OmarSaadany/Weather-Station/DOCs/Weather Station Proposal.docx

Item | | Price | link
2 | Solar Panel | 400 | https://ampere-electronics.com/product/solar-panel-10w-18v-238x360mm/
3 | Charge Controller | 450 | https://ram-e-shop.com/product/pwm-solar-charge-controller-12v-24v-auto-30a-ft-d1230/
4 | Battery 12 v | 450 | https://makerselectronics.com/product/acid-battery-12v-2ah
5 | GSM | 2x220 | https://store.fut-electronics.com/products/sim800l-gprs-gsm-module?_pos=9&_sid=cd140909e&_ss=r
6 | Blue Pill | 2x180 | https://store.fut-electronics.com/products/copy-of-stm32f103c8t6-stm32-development-board-original-ic-the-blue-pill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
7 | Limit Switch | 10x2 | https://ram-e-shop.com/product/ms-3/
8 | 5X Regulator | 5x5=25 | https://ram-e-shop.com/product/lm317t/
| Flow sensor | 375 | https://ram-e-shop.com/product/sen-fs300a-water-flow/
| Female Pin Headers | 5x3 | https://store.fut-electronics.com/products/female-pin-headers-standard-2-54-mm-40-pin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
| male-male-jumper | 1.5 | https://store.fut-electronics.com/products/male-male-jumper-wire-400-mm?_pos=3&_sid=816fa6d71&_ss=r
| Male female | 1.5 | https://store.fut-electronics.com/products/male-female-jumper-wire-400-mm?_pos=7&_sid=816fa6d71&_ss=r
| Female female | 1.5 | https://store.fut-electronics.com/products/female-female-jumper-wire-400-mm?_pos=12&_sid=816fa6d71&_ss=r
| T block 4pins | 5*5 | https://store.fut-electronics.com/products/pcb-terminal-block-5mm-pitch-4pin?_pos=11&_sid=86df6474a&_ss=r
| 3 pins | 4 | https://store.fut-electronics.com/products/pcb-terminal-block-5mm-pitch-3pin?_pos=12&_sid=86df6474a&_ss=r
| Heat sink | 4.5 LE*6 | https://store.fut-electronics.com/products/heatsink-1?_pos=1&_sid=44304f6ac&_ss=r
| 7805 | 5LE*3 | https://store.fut-electronics.com/products/l7805cv-positive-voltage-regulator-5v-1a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
| Rotary encoder | 55 | https://ram-e-shop.com/product/kit-ky040-rotary-encoder/
| Magnetic encoder | 160 | https://store.fut-electronics.com/products/magnetic-encoder-rotary-position-sensor-as5600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
| IR Encoder | 180 | https://ram-e-shop.com/product/speed-measuring-module-encoder-disk-set-for-smart-car-chassis/
