OmarSaadany/Weather-Station/PCB Design/V2/GSM.DXF

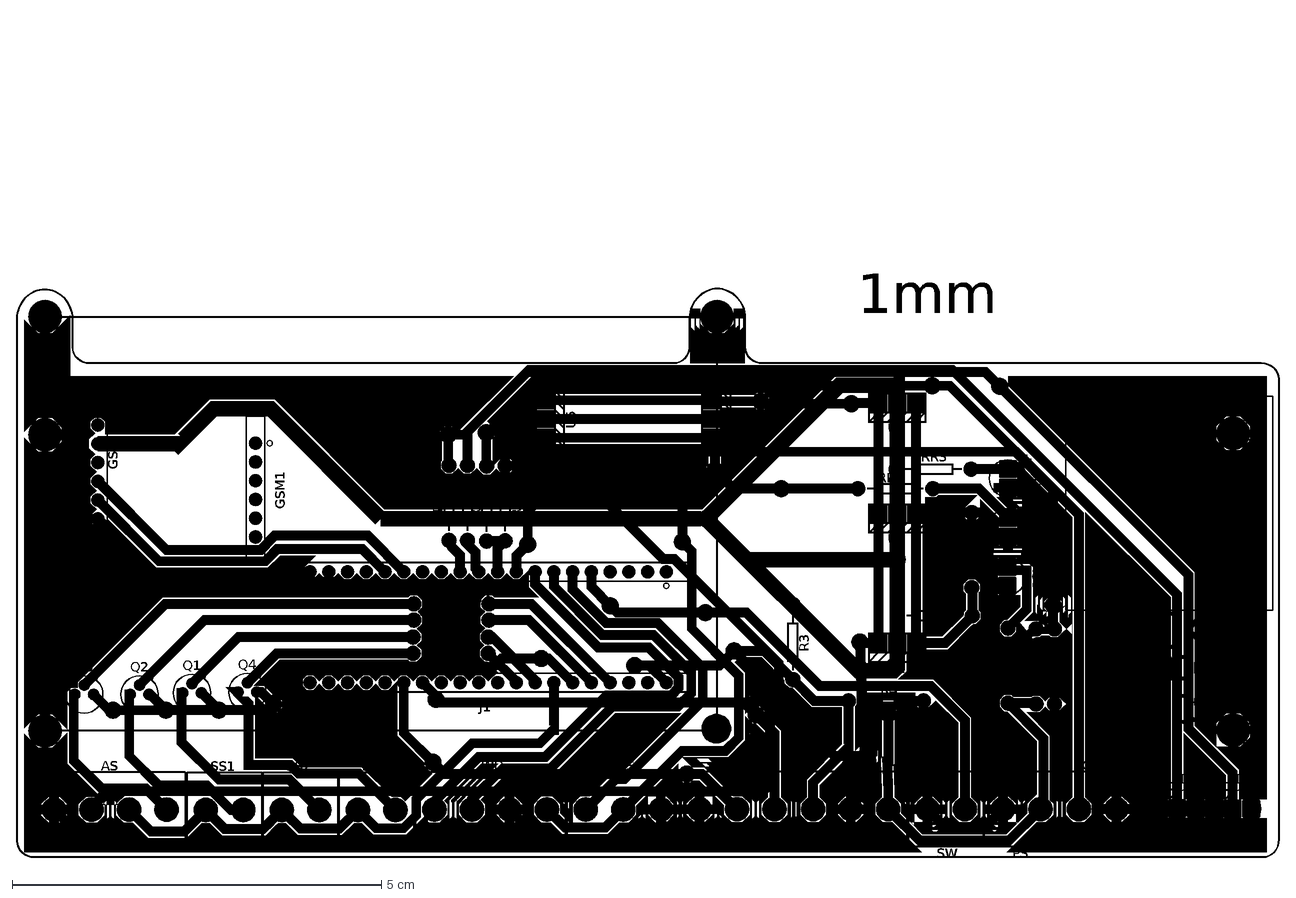
[picture p35: CAD file, 2024-02-18]
PCB Design/V2/GSM.DXF
GSM
J1
J2
GSM1
AS
Q4
R8
R5
Q1
PS
U1
U2
U3
U4
U5
12V
5V
RR1
RR2
Q2
R6
Q3
R7
R1
R2
R3
R4
SW
WD
WS
4V
RR3
S1
S2
SS1
SS2
SS3
R11
R12
R9
R10
R
RR
SOLAR
LED1
LED2
1mm
DK
Innovation
Labs
40mm
