OmarSaadany/Weather-Station/PCB Design/V2/GSM.PDF

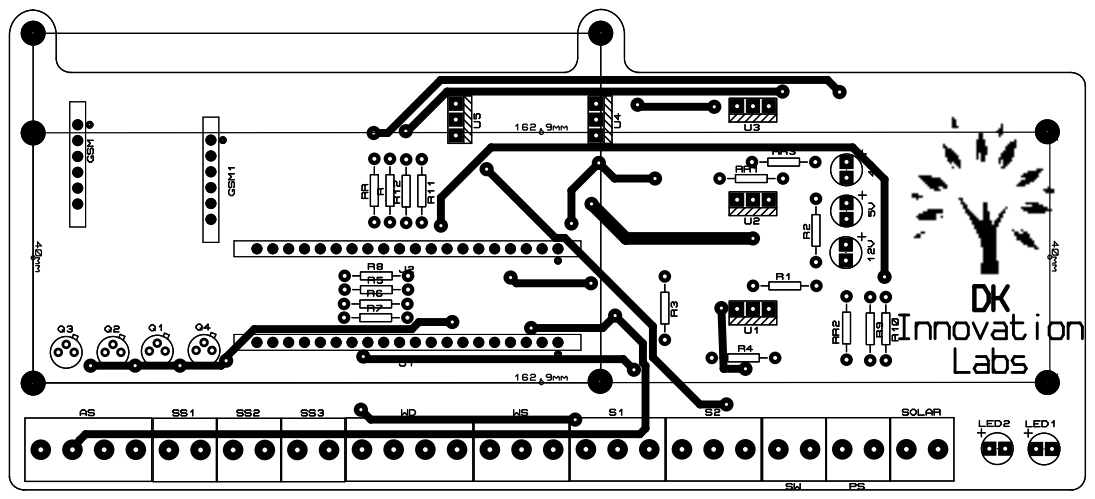
[picture p36: page 1]
