OmarSaadany/Weather-Station/PCB Design/Manufacturing Files/GSM_Mirror.PDF

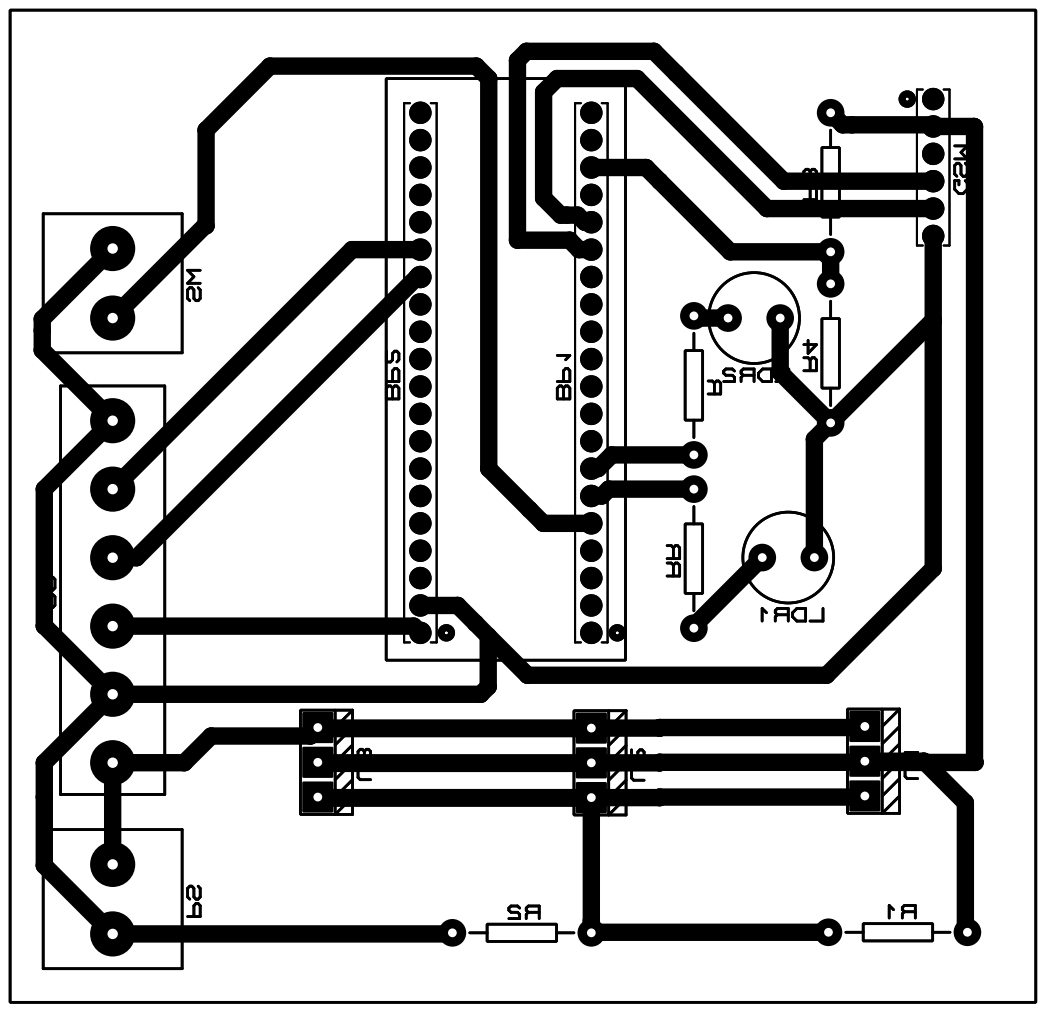
[picture p37: page 1]
