OmarSaadany/Weather-Station/(list of files, drawings)

Other design files:
PCB Design/Proteus Design/GSM.pdsprj
PCB Design/V2/GSM.pdsprj
PCB Design/V2/Project Backups/GSM [20231207, 17-36-30].pdsprj
PCB Design/V2/Project Backups/GSM [20231207, 17-36-31].pdsprj
PCB Design/V2/Project Backups/GSM [20231207, 17-36-32].pdsprj
PCB Design/V2/Project Backups/GSM [20240116, 13-15-07].pdsprj
PCB Design/V2/Project Backups/GSM [20240116, 13-17-36].pdsprj
PCB Design/V2/Project Backups/GSM [20240118, 11-22-48].pdsprj
PCB Design/V2/Project Backups/GSM [20240118, 11-44-44].pdsprj
PCB Design/V2/Project Backups/GSM [20240118, 12-48-58].pdsprj
PCB Design/V2/Project Backups/GSM [20240118, 12-49-00].pdsprj
PCB Design/V2/Project Backups/GSM [20240118, 12-51-57].pdsprj
