OmarSaadany/Weather-Station/Wind sensors/Inc/SoilSensor.h

/*
 * SoilSensor.h
 *
 *  Created on: Nov 8, 2023
 *      Author: SaadanyOmar
 */

#ifndef SOILSENSOR_H_
#define SOILSENSOR_H_
#include "STD_TYPES.h"
#include "BIT_MATH.h"
#include "USART_interface.h"

void SOIL_voidSensorReadData(void);


#endif /* SOILSENSOR_H_ */
