OmarSaadany/Weather-Station/Wind sensors/Src/GSM_program.c

/*
 * GSM_program.c
 *
 *  Created on: Nov 8, 2023
 *      Author: SaadanyOmar
 */

#include "STD_TYPES.h"
#include "BIT_MATH.h"
#include "GSM_interface.h"
#include "USART3_interface.h"


// this string used with GSM_voidSendData function to convert float numbers into array by using ftoa function
u8 ftoa_Result[20];


// these data are global in SOILSENSOR files and updated before calling GSM_voidSendData
extern f32 soilHumidity	 	    ;
extern f32 soilTemperature  	;
extern u16 soilConductivity 	;
extern f32 soilPH 				;
extern u16 soilnitrogen 		;
extern u16 soilphosphorus 		;
extern u16 soilpotassium 		;
extern f32 SensorTempRead       ;
extern f32 SensorHumdRead       ;
extern u8  DoorStatus			;
extern f32 volt					;


extern u8 GSMSTATUS[25]			; 	// used to receive GSM respond after uploading data to reconnect to the network if the upload failed
u8 GSMTimeOut=0			;	// time out used to detect if the GSM did not respond to prevent the CPU to stuck in Receiving function



// simple busy wait function
void	_delay_ms(u32 ticks)
{
	u32 i;
	for( i = 0; i < (ticks * 500) ; i++)
	{
		asm("NOP");
	}
}



/* Function:-			void GSM_voidConnectToNetwork(void);
 * I/O Parameters:-		void
 * Returns:- 			Void
 * Description:-
 * 		connect GSM to network and initialize HTTP mode
 */
void GSM_voidConnectToNetwork (void)
{
	// send AT to make GSM ready to start and sync with boud rate
	USART3_voidSendString("AT");
	USART3_voidSendString("\r\n");
	_delay_ms(100);
	USART3_voidSendString("AT");
	USART3_voidSendString("\r\n");
	_delay_ms(1000);
	USART3_voidSendString("AT+CPIN?");
	USART3_voidSendString("\r\n");
	_delay_ms(1000);
	USART3_voidSendString("AT+CFUN=1");
	USART3_voidSendString("\r\n");
	_delay_ms(1000);
	USART3_voidSendString("AT+CREG?");
	USART3_voidSendString("\r\n");
	_delay_ms(1000);
	USART3_voidSendString("AT+CGATT?");
	USART3_voidSendString("\r\n");
	_delay_ms(1000);
	USART3_voidSendString("AT+SAPBR=3,1,\"CONTYPE\",\"GPRS\"");
	USART3_voidSendString("\r\n");
	_delay_ms(1000);
	USART3_voidSendString("AT+SAPBR=3,1,\"APN\",\"internet.vodafone.net\"");
	USART3_voidSendString("\r\n");
	_delay_ms(1000);
	USART3_voidSendString("AT+SAPBR=3,1,\"USER\",\"internet\"");
	USART3_voidSendString("\r\n");
	_delay_ms(1500);
	USART3_voidSendString("AT+SAPBR=1,1");
	USART3_voidSendString("\r\n");
	_delay_ms(1000);
	USART3_voidSendString("AT+SAPBR=2,1");
	USART3_voidSendString("\r\n");
	_delay_ms(1500);
	USART3_voidSendString("AT+HTTPINIT");
	USART3_voidSendString("\r\n");

}




/* Function:-			void GSM_voidSendData(void);
 * I/O Parameters:-		void
 * Returns:- 			Void
 * Description:-
 * 		update data to google sheet
 */
void GSM_voidSendData(void)
{
	USART3_voidSendString("AT");
	USART3_voidSendString("\r\n");
	_delay_ms(50);
	USART3_voidSendString("AT");
	USART3_voidSendString("\r\n");
	_delay_ms(50);
	// enable HTTPSSL
	USART3_voidSendString("AT+HTTPSSL=1");
	USART3_voidSendString("\r\n");
	_delay_ms(500);

	// Send google sheet script link
	USART3_voidSendString("AT+HTTPPARA=\"URL\",\"https://script.google.com/macros/s/AKfycbykF8SKIREqFvZkoBSAbIT5z8wO0gK62gn2uFlCY_dtvy8bBGt6Wy3nKZo4f5hE1kPP/exec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");

	// scaleID= is the first macro then send its value as string
	USART3_voidSendString("soilHumidity=");
	ftoa(soilHumidity, ftoa_Result, 2);
	USART3_voidSendString(ftoa_Result);

	USART3_voidSendString("&soilTemperature=");
	ftoa(soilTemperature, ftoa_Result, 2);
	USART3_voidSendString(ftoa_Result);

	USART3_voidSendString("&soilConductivity=");
	intToStr(soilConductivity, ftoa_Result, 3) ;
	USART3_voidSendString(ftoa_Result);

	USART3_voidSendString("&soilPH=");
	ftoa(soilPH, ftoa_Result, 2);
	USART3_voidSendString(ftoa_Result);

	USART3_voidSendString("&soilNitrogen=");
	intToStr(soilnitrogen, ftoa_Result, 2) ;
	USART3_voidSendString(ftoa_Result);

	USART3_voidSendString("&soilPhosphorus=");
	intToStr(soilphosphorus, ftoa_Result, 2) ;
	USART3_voidSendString(ftoa_Result);

	USART3_voidSendString("&soilPotassium=");
	intToStr(soilpotassium, ftoa_Result, 2) ;
	USART3_voidSendString(ftoa_Result);

	USART3_voidSendString("&airTemperature=");
	ftoa(SensorTempRead, ftoa_Result, 2);
	USART3_voidSendString(ftoa_Result);

	USART3_voidSendString("&airHumididty=");
	ftoa(SensorHumdRead, ftoa_Result, 2);
	USART3_voidSendString(ftoa_Result);


	if (DoorStatus==0)
	{
		USART3_voidSendString("&doorStatus=Closed");
	}
	else
	{
		USART3_voidSendString("&doorStatus=Opened");
	}

	USART3_voidSendString("&volt=");
	ftoa(volt, ftoa_Result, 2);
	USART3_voidSendString(ftoa_Result);

	USART3_voidSendString("\"\r\n");
	_delay_ms(3000);

	USART3_voidSendString("AT+HTTPACTION=0");
	USART3_voidSendString("\r\n");
	_delay_ms(3000);
}





void GSM_voidReceivedStatus (void)
{
	// receive 23 character as a respond from GSM
	for (u8 i =0 ; i<23; i++)
	{
		if(i == 0) 				// the first char in expected respond array is '+' so we need a special condition for the first element until we receive '+'
		{
			while (GSMSTATUS[0]!='+' && GSMTimeOut<250) // while it did not receive '+' and the time out value is less than 250, stay in the loop
			{
				GSMSTATUS[0]=USART3_u8ReciveData();		// Receive byte and save it in the first element
				GSMTimeOut++;							// increment the timeout value
			}
			GSMTimeOut=0;								// Timeout value = 0 to use it in the next loop

			if (GSMSTATUS[0]!='+' ) // if timeout exceeded the limit and the USART did not receive '+' in the first element
			{
				break;				// break the FOR loop
			}
		}

		else // if i bigger than 0
		{
			GSMSTATUS[i]=USART3_u8ReciveData(); 		//  Receive byte and save it in the (index of i) element
		}
	}

}


/* Function:-			void GSM_voidPhoneCall(u8* PhoneNumSTR);
 * I/O Parameters:-		u8*
 * Returns:- 			Void
 * Description:-
 * 		used to make a phone call
 */
void GSM_voidPhoneCall(u8* PhoneNumSTR){
	// use ATD command to make a phone call
	USART3_voidSendString("ATD");
	USART3_voidSendString(PhoneNumSTR);
	USART3_voidSendString(";\r\n");

}


/* Function:-			void GSM_voidSendSMS (u8* PhoneNumSTR, u8* SMS);
 * I/O Parameters:-		u8*, u8*
 * Returns:- 			Void
 * Description:-
 * 		used to make a phone call
 */
void GSM_voidSendSMS (u8* PhoneNumSTR, u8* SMS)
{
	USART3_voidSendString("AT+CMGF=1");
	USART3_voidSendString("\r\n");
	_delay_ms(100);
	USART3_voidSendString("AT+CMGS=");
	USART3_voidSendByte('"');
	USART3_voidSendString(PhoneNumSTR);
	USART3_voidSendByte('"');
	USART3_voidSendString("\r\n");
	_delay_ms(100);
	USART3_voidSendString(SMS);
	USART3_voidSendString("\r\n");
	USART3_voidSendByte(0x1A);
}






void reverse(u8* str, u16 len)
{
	// this func reverse the string
	int i = 0, j = len - 1, temp;
	while (i < j) {
		temp = str[i];
		str[i] = str[j];
		str[j] = temp;
		i++;
		j--;
	}
}

u16  intToStr(u16 x, u8 str[], u16 d)
{// change int value to string of char
	u16 i = 0;
	while (x) {
		str[i++] = (x % 10) + '0';
		x = x / 10;
	}

	// If number of digits required is more, then
	// add 0s at the beginning
	while (i < d)
		str[i++] = '0';

	reverse(str, i);
	str[i] = '\0';
	return i;
}

// Converts a floating-point/double number to a string.
void ftoa(f32 n, u8* res, u16 afterpoint)
{
	// Extract integer part
	u16 ipart = (u16)n;

	// Extract floating part
	f32 fpart = n - (f32)ipart;

	// convert integer part to string
	u16 i = intToStr(ipart, res, 0);

	// check for display option after point
	if (afterpoint != 0) {
		res[i] = '.'; // add dot

		// Get the value of fraction part upto given no.
		// of points after dot. The third parameter
		// is needed to handle cases like 233.007
		fpart = fpart * pow(10, afterpoint);

		intToStr((u16)fpart, res + i + 1, afterpoint);
	}
}
