OmarSaadany/Weather-Station/Wind sensors/Inc/TIM2_config.h

/*
 * TIM2_config.h
 *
 *  Created on: Jan 9, 2024
 *      Author: SaadanyOmar
 */

#ifndef TIM2_CONFIG_H_
#define TIM2_CONFIG_H_




#define 	TIM2_Mode				TIM2_CounterMode




#define		TIM2_CounterMode 		1


#define 	TIM2_ReloadValue		0xffff


#endif /* TIM2_CONFIG_H_ */
