OmarSaadany/Weather-Station/Wind sensors/Inc/TIM2_interface.h

/*
 * TIM2_interface.h
 *
 *  Created on: Jan 9, 2024
 *      Author: SaadanyOmar
 */

#ifndef TIM2_INTERFACE_H_
#define TIM2_INTERFACE_H_


void TIM2_voidInit (void);

u32  TIM2_u32GetCounterValue (void);


#endif /* TIM2_INTERFACE_H_ */
