OmarSaadany/Weather-Station/Wind sensors/Inc/TIM3_config.h

/*
 * TIM2_config.h
 *
 *  Created on: Jan 8, 2024
 *      Author: SaadanyOmar
 */

#ifndef TIM3_CONFIG_H_
#define TIM3_CONFIG_H_



#define 	TIM3_Mode				TIM3_EncoderMode




#define		TIM3_EncoderMode 		1


#define 	TIM3_ReloadValue		60

#endif /* TIM3_CONFIG_H_ */
