OmarSaadany/Weather-Station/Wind sensors/Inc/TIM3_interface.h

/*
 * TIM2_interface.h
 *
 *  Created on: Jan 8, 2024
 *      Author: SaadanyOmar
 */

#ifndef TIM3_INTERFACE_H_
#define TIM3_INTERFACE_H_


void TIM3_voidInit (void);

u32  TIM3_u32GetCounterValue (void);



#endif /* TIM3_INTERFACE_H_ */
