OmarSaadany/Weather-Station/Wind sensors/Inc/SHT.h

/*
 * SHT.h
 *
 *  Created on: Nov 9, 2023
 *      Author: SaadanyOmar
 */

#ifndef SHT_H_
#define SHT_H_


void SHT_SensorInit(void);

f32 SHT_RecieveTemp(void);


f32 SHT_RecieveHumd(void);

#endif /* SHT_H_ */
