OmarSaadany/Weather-Station/GPS/Code/Inc/AFIO_config.h

/*
 * AFIO_config.h
 *
 *  Created on: Oct 9, 2023
 *      Author: SaadanyOmar
 */
#ifndef AFIO_CONFIG_H_
#define AFIO_CONFIG_H_

// Select Remap or NoRemap
// if you want to use the default peripheral's pins ----> NoRemap
// if you want to use the Remap   peripheral's pins ----> Remap
#define SPI1Remap	    NoRemap
#define I2C1Remap	    NoRemap
#define USART1Remap	    NoRemap
#define USART2Remap	    NoRemap
#define USART3Remap	    NoRemap
#define TIM1Remap	    NoRemap
#define TIM2Remap	    NoRemap
#define TIM3Remap	    NoRemap


#endif /* AFIO_CONFIG_H_ */
