OmarSaadany/Weather-Station/GPS/Code/Src/DIO_program.c

/*
 * 	DIO.c
 *
 *  Created on: Oct, 2023
 *      Author: SaadanyOmar
 */


#include	"STD_TYPES.h"
#include	"BIT_MATH.h"

#include	"DIO_interface.h"
#include	"DIO_private.h"





void	DIO_voidSetPinDirection(u8 port, u8 pin, u8 Direction)
{
	/*		Range Check 		*/
	if(port < 3 && pin < 16)
	{
		if(pin<8)	/*		Low	(PIN0:PIN7) CRL	*/
		{
			switch(port)
			{
				case	PORTA	:
				/*		Clear the 4 bits before writing		*/
				GPIOA->CRL &= ~((0b1111)<<(pin * 4));
				/*		Assign the Direction value			*/
				GPIOA->CRL |=  ((Direction)<<(pin * 4));
				break;
				
				case	PORTB	:
				/*		Clear the 4 bits before writing		*/
				GPIOB->CRL &= ~((0b1111)<<(pin * 4));
				/*		Assign the Direction value			*/
				GPIOB->CRL |=  ((Direction)<<(pin * 4));
				break;
				
				case	PORTC	:
				/*		Clear the 4 bits before writing		*/
				GPIOC->CRL &= ~((0b1111)<<(pin * 4));
				/*		Assign the Direction value			*/
				GPIOC->CRL |=  ((Direction)<<(pin * 4));
				break;
			}
		}else if(pin<16)	/*		Low	(PIN8:PIN15) CRL	*/
		{
			pin -= 8;
			switch(port)
			{
				case	PORTA	:
				/*		Clear the 4 bits before writing		*/
				GPIOA->CRH &= ~((0b1111)<<(pin * 4));
				/*		Assign the Direction value			*/
				GPIOA->CRH |=  ((Direction)<<(pin * 4));
				break;
				
				case	PORTB	:
				/*		Clear the 4 bits before writing		*/
				GPIOB->CRH &= ~((0b1111)<<(pin * 4));
				/*		Assign the Direction value			*/
				GPIOB->CRH |=  ((Direction)<<(pin * 4));
				break;
				
				case	PORTC	:
				/*		Clear the 4 bits before writing		*/
				GPIOC->CRH &= ~((0b1111)<<(pin * 4));
				/*		Assign the Direction value			*/
				GPIOC->CRH |=  ((Direction)<<(pin * 4));
				break;
			}

		}
	}else{/*	Return Error	*/}
}
void	DIO_voidSetPinValue(u8 port, u8 pin, u8 Value)
{
	/*		Range Check 		*/
	if(port < 3 && pin < 16)
	{
		if(Value == GPIO_HIGH)
		{
			switch(port)
			{
				case	PORTA	:	GPIOA_set_pin;		break;
				case	PORTB	:	GPIOB_set_pin;		break;
				case	PORTC	:	GPIOC_set_pin;		break;
			}
		}
		else if(Value == GPIO_LOW)
		{
			switch(port)
			{
				case	PORTA	:	GPIOA_clr_pin;		break;
				case	PORTB	:	GPIOB_clr_pin;		break;
				case	PORTC	:	GPIOC_clr_pin;		break;
			}			
		}
		
	}else{/*	Return Error	*/}
	
}
u8		DIO_u8GetPinValue(u8 port, u8 pin)
{
	/*		Range Check 		*/
	u8	Local_u8Val = 0x99;
	if(port < 3 && pin < 16)
	{

			switch(port)
			{
				case	PORTA	:	Local_u8Val	=	get_bit(GPIOA->IDR,pin);	break;
				case	PORTB	:	Local_u8Val	=	get_bit(GPIOB->IDR,pin);	break;
				case	PORTC	:	Local_u8Val	=	get_bit(GPIOC->IDR,pin);	break;
			}
	}else{/*	Return Error	*/}	
	return Local_u8Val;
}



void	DIO_voidTogllePinValue(u8 port, u8 pin)
{
	/*		Range Check 		*/
	if(port < 3 && pin < 16)
	{

			switch(port)
			{
				case	PORTA	:	tog_bit(GPIOA->ODR,pin);		break;
				case	PORTB	:	tog_bit(GPIOB->ODR,pin);		break;
				case	PORTC	:	tog_bit(GPIOC->ODR,pin);		break;
			}


	}else{/*	Return Error	*/}

}
