OmarSaadany/Weather-Station/Wind sensors/Inc/NVIC_config.h

/*
 * 	NVIC_config.h
 *
 *  Created on: Oct, 2023
 *      Author: SaadanyOmar
 */


#ifndef		NVIC_CONFIG_H
#define		NVIC_CONFIG_H



#define		NVIC_NUM_GRP_SUB				GRB_04_SUB_04


/********************
-  CAN BE OPTIONS

  GRB_16_SUB_00
  GRB_08_SUB_02
  GRB_04_SUB_04
  GRB_02_SUB_08
  GRB_00_SUB_16
  
  *///////////////
  
#endif
