OmarSaadany/Weather-Station/Wind sensors/Inc/NVIC_interface.h

/*
 * 	NVIC_interface.h
 *
 *  Created on: Oct, 2023
 *      Author: SaadanyOmar
 */

#ifndef		NVIC_INTERFACE_H
#define		NVIC_INTERFACE_H

void		NVIC_voidInit();

void		NVIC_voidEnablePerInt(u8 IntNum);
void		NVIC_voidDisablePerInt(u8 IntNum);

void		NVIC_voidSetPendingFlag(u8 IntNum);
void		NVIC_voidClrPendingFlag(u8 IntNum);

u8			NVIC_u8ReadActiveFlag(u8 IntNum);

void		NVIC_voidSetSwIntPriority(u8 IntNum , u8 priority);

#endif
