OmarSaadany/Weather-Station/(commit log)

2023-11-08 PCB Design
    [GSM.pdsprj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]
2024-02-18 complete weather station
    [GSM [20231113, 17-25-02].pdsprj, GSM [20231207, 17-36-30].pdsprj, GSM [20231207, 17-36-31].pdsprj, GSM [20231207, 17-36-32].pdsprj, GSM [20240116, 13-15-07].pdsprj, GSM [20240116, 13-17-36].pdsprj, GSM [20240118, 11-22-48].pdsprj, GSM [20240118, 11-44-44].pdsprj]
2024-02-18 wind sensors
